LyricHa/ECEN403-CAPSTONE/ECEN404_Team60_Solar_Lighting_System/Presentations/ECEN 404 Presentations/PDFs/ECEN404_Presentation_2-28.pdf

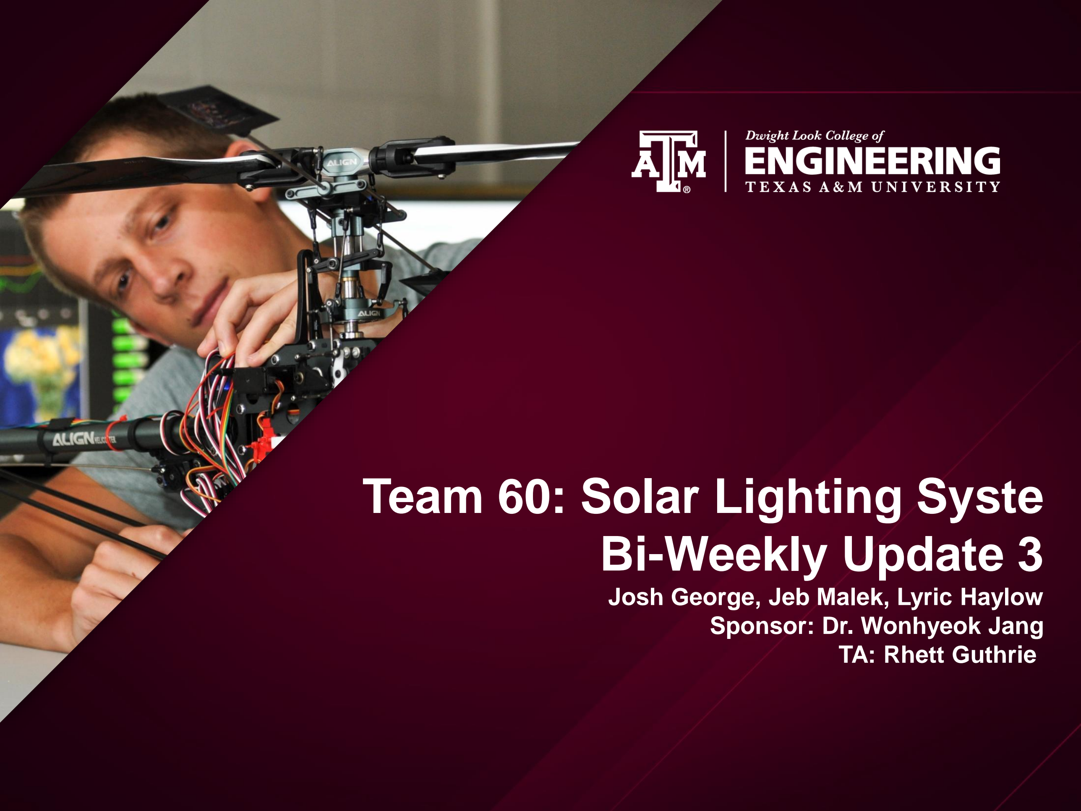
[picture p93: page 1]

# Team 60: Solar Lighting Syste Bi-Weekly Update 3

Josh George, Jeb Malek, Lyric Haylow Sponsor: Dr. Wonhyeok Jang TA: Rhett Guthrie

# Project Summary

### - A need for clean, renewable sources becomes more apparent

than ever.

### - Our home indoor and outdoor lighting system is the first step

towards this, using solar power.

### - Design an indoor/outdoor home lighting system that operates with

a battery, power conversion,

### mobile application functionality, BT microcontroller for switch automation from motion

sensors.

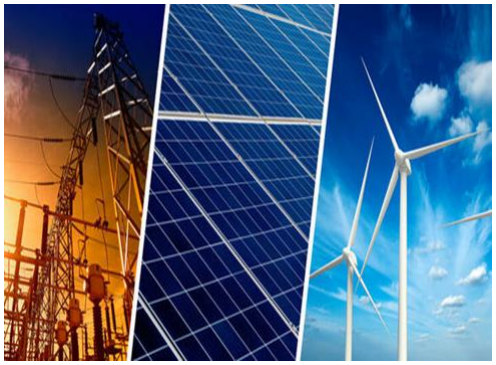
[picture p94: figure]

# Project/Subsystem Overview

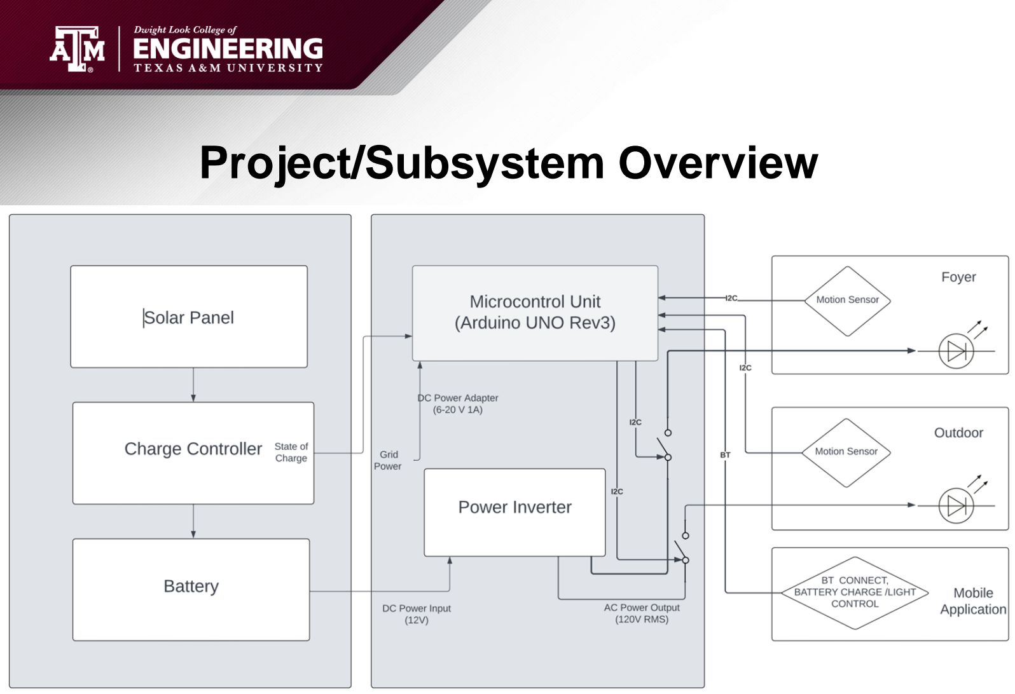
[picture p95: page 3]

# Project Timeline

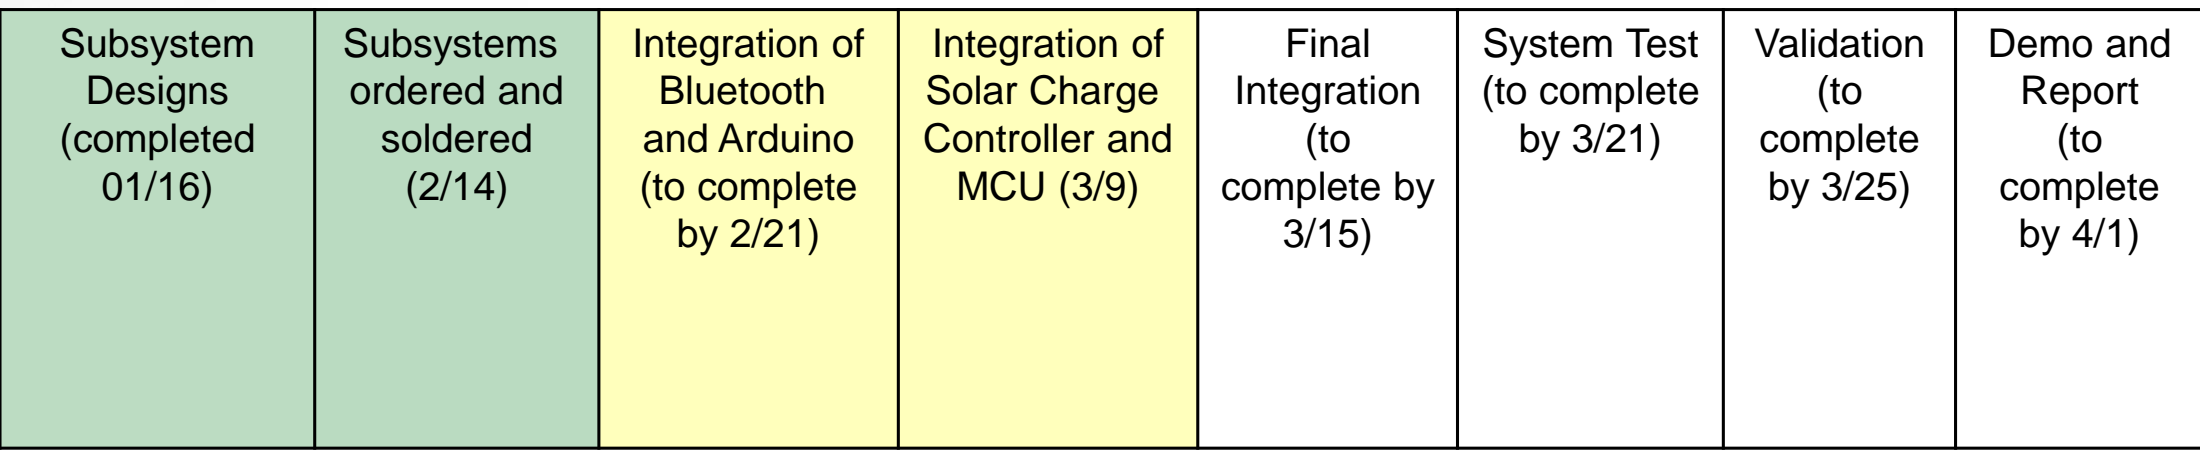
[picture p96: figure]
Subsystem Designs (completed 01/16); Subsystems ordered and soldered (2/14); Integration of Bluetooth and Arduino (to complete by 2/21); Integration; Solar; Charge; Controller; and; MCU; Final Integration (to complete by 3/15); System Test (to complete by 3/21); Validation (to complete by 3/25); Demo and Report (to complete by 4/1)

# Solar Charge Controller

Accomplishments since last update 10 hrs of effort | Ongoing progress/problems and plans until the next presentation
- PCB board soldered - Gotten voltage output from one of the solar panels, confirmed working - Preliminary datapoints for battery percentage attained. Likely wrong though. | - Print 3D model for enclosure over Blitz - Finish verifying necessary final values for Charge Controller - Sun is temperamental and necessary for good testing.

Time (AM) | Change in time (minutes) | Battery Voltage (Voltage

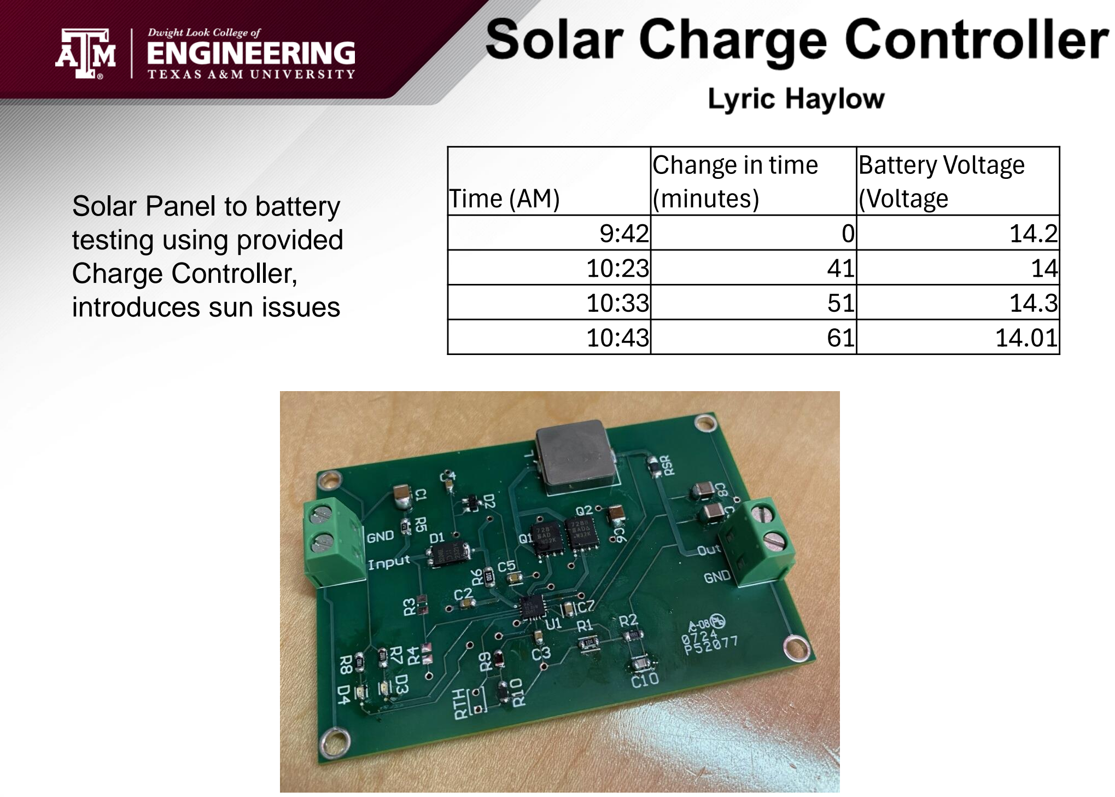
[picture p97: page 6]

9:42 | 0 | 14.2
10:23 | 41 | 14
10:33 | 51 | 14.3
10:43 | 61 | 14.01

Solar Panel to battery
testing using provided
Charge Controller,
introduces sun issues

# Inverter Subsystem

Jeb Malek

Accomplishments since 403 25 hrs of effort | Ongoing progress/problems and plans until the next presentation
Power transformer voltage invalidated In-circuit serial programming issue | PCB Correction Ordering Corrected Version Assembly & Validation 12V – 5V Converter PCB Order
- Evaluated Configuration Bits for Programming dsPIC

Speaking with sponsor about alternative changes to scope.

# Inverter Subsytem

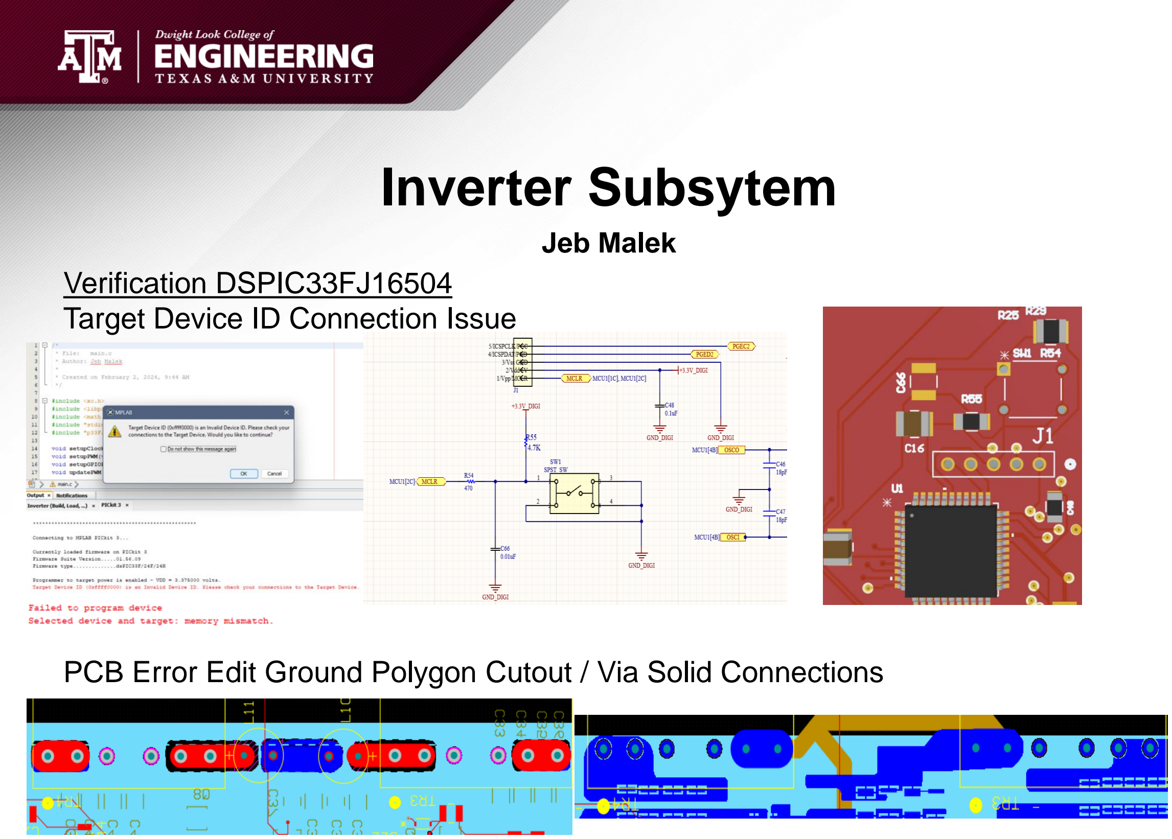
[picture p98: page 8]

Jeb Malek
Verification DSPIC33FJ16504 Target Device ID Connection Issue

PCB Error Edit Ground Polygon Cutout / Via Solid Connections

# Inverter Subsytem

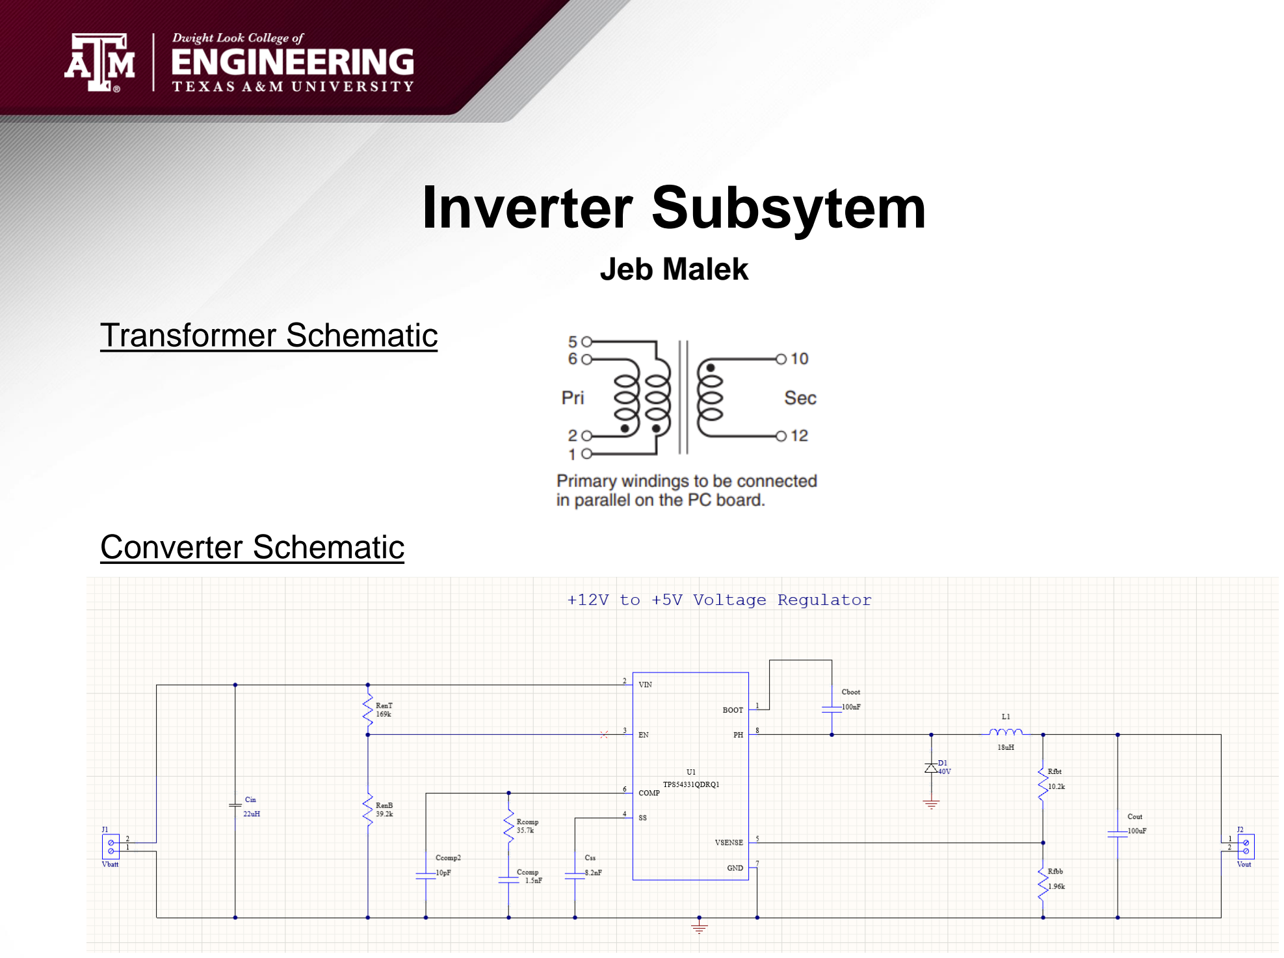
[picture p99: page 9]

Jeb Malek

Converter Schematic

Transformer Schematic

# Microcontroller Subsystem

Jeb Malek & Josh George

Accomplishments since 403 20 hrs of effort | Ongoing progress/problems and plans until the next presentation
Passive Infared (PIR) Sensors Tested Coded microcontroller sensor relay information | Testing of Sensor proximity & distance Testing of Controlled Relay Communication with Arduino Testing of Relay with Light Load
- Evaluated Sensor High & Low Communication Signal
- Future Test Bluetooth App with relay control, receive of motion sense, sign of demonstration structuring

# Microcontroller Subsytem

Jeb Malek & Josh George

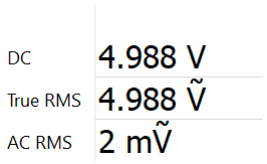
[picture p100: figure]

PIR Motion Sensor Test

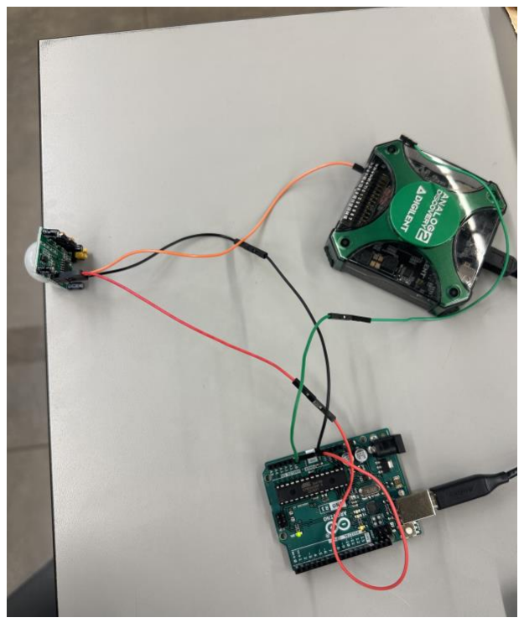
[picture p101: figure]
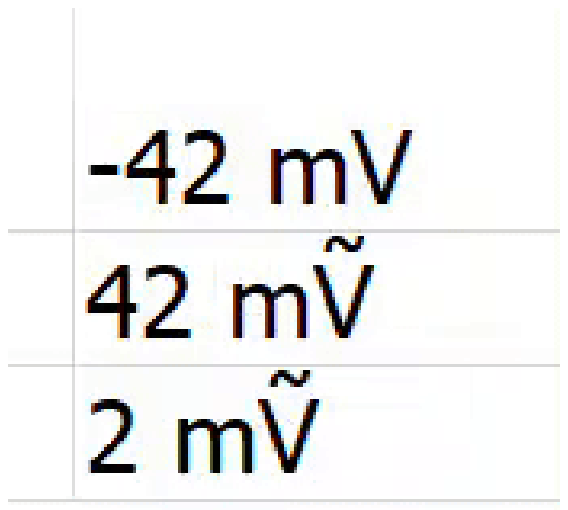
[picture p102: figure]

## Microcontroller Subsytem

Jeb Malek & Josh George Sensor 1 Reading Pin

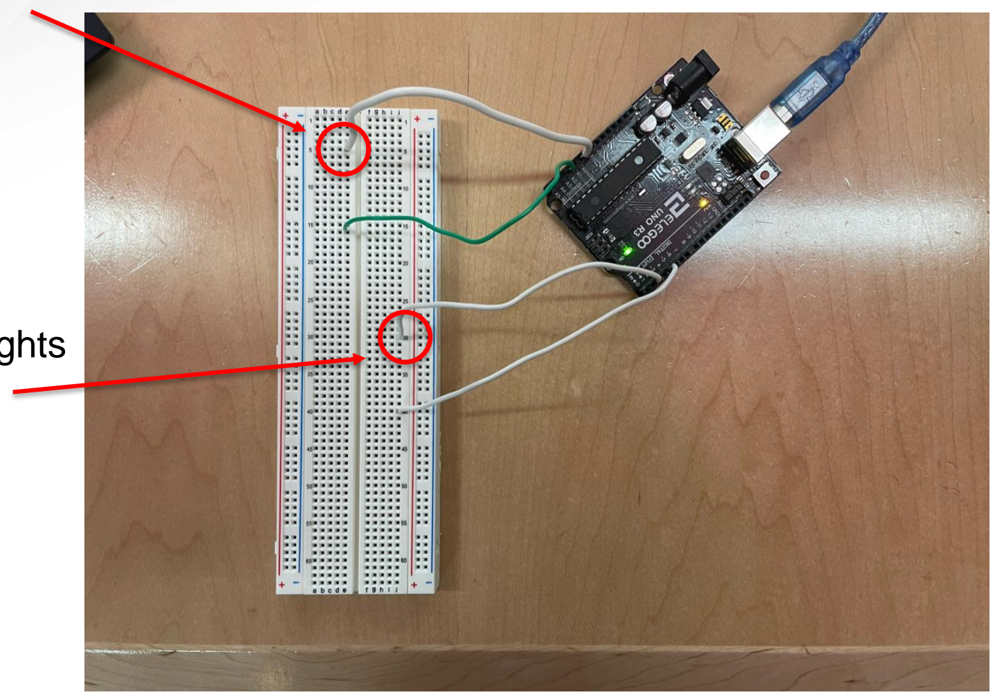
[picture p103: figure]

Sensor 1 Lights

## Microcontroller Subsytem

Jeb Malek & Josh George
Sensor 2 Reading Pin

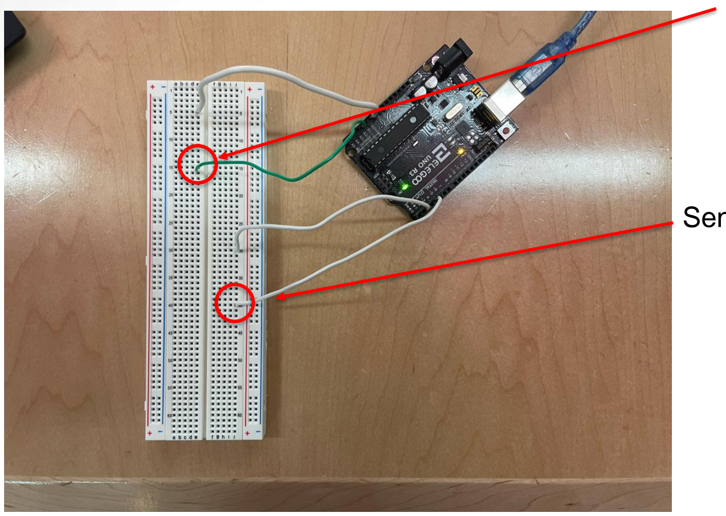
[picture p104: figure]

Sensor 2 Lights

## Microcontroller Subsytem

Jeb Malek & Josh George

# - Main error found during testing: Sensor 1 activates Sensor 2 lights too, and Sensor

2 activates sensor lights as well.

# Mobile Application

Josh George

Accomplishments since last update 2 hrs of effort | Ongoing progress/problems and plans until the next presentation
-Added Bluetooth special characters functionality. | -Finish coding microcontroller sensor relay. -Add input pin option for solar charge controller.

# Mobile Application

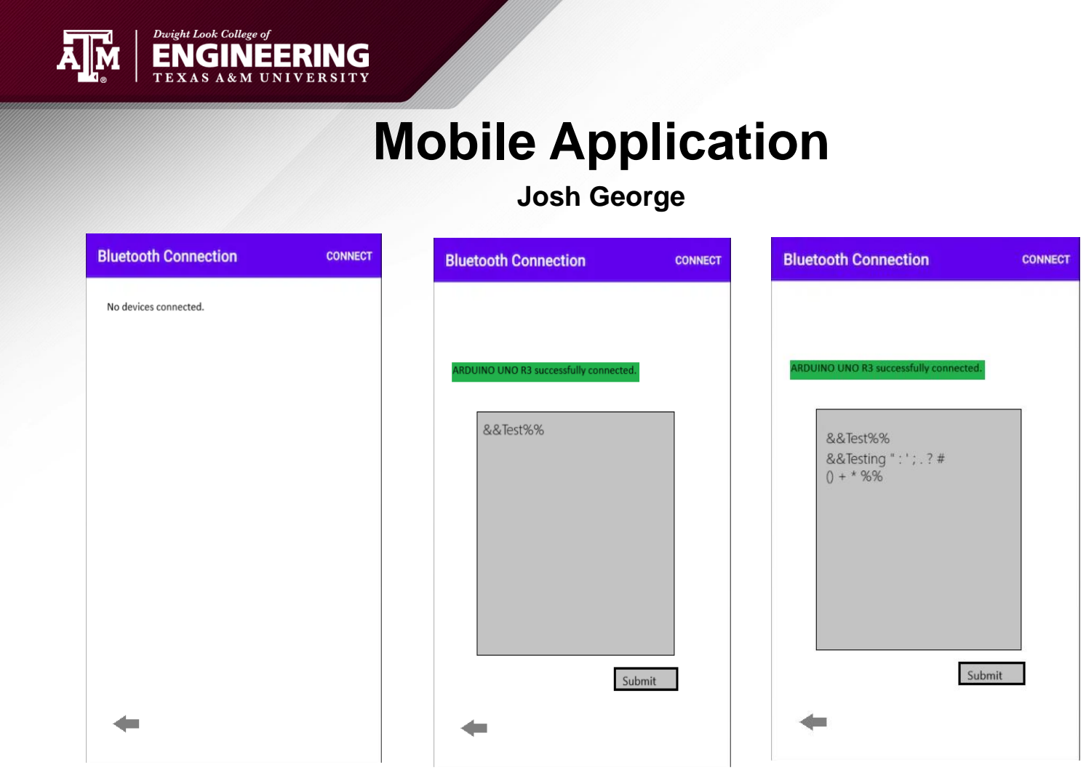
[picture p105: page 16]

Josh George

# Execution Plan

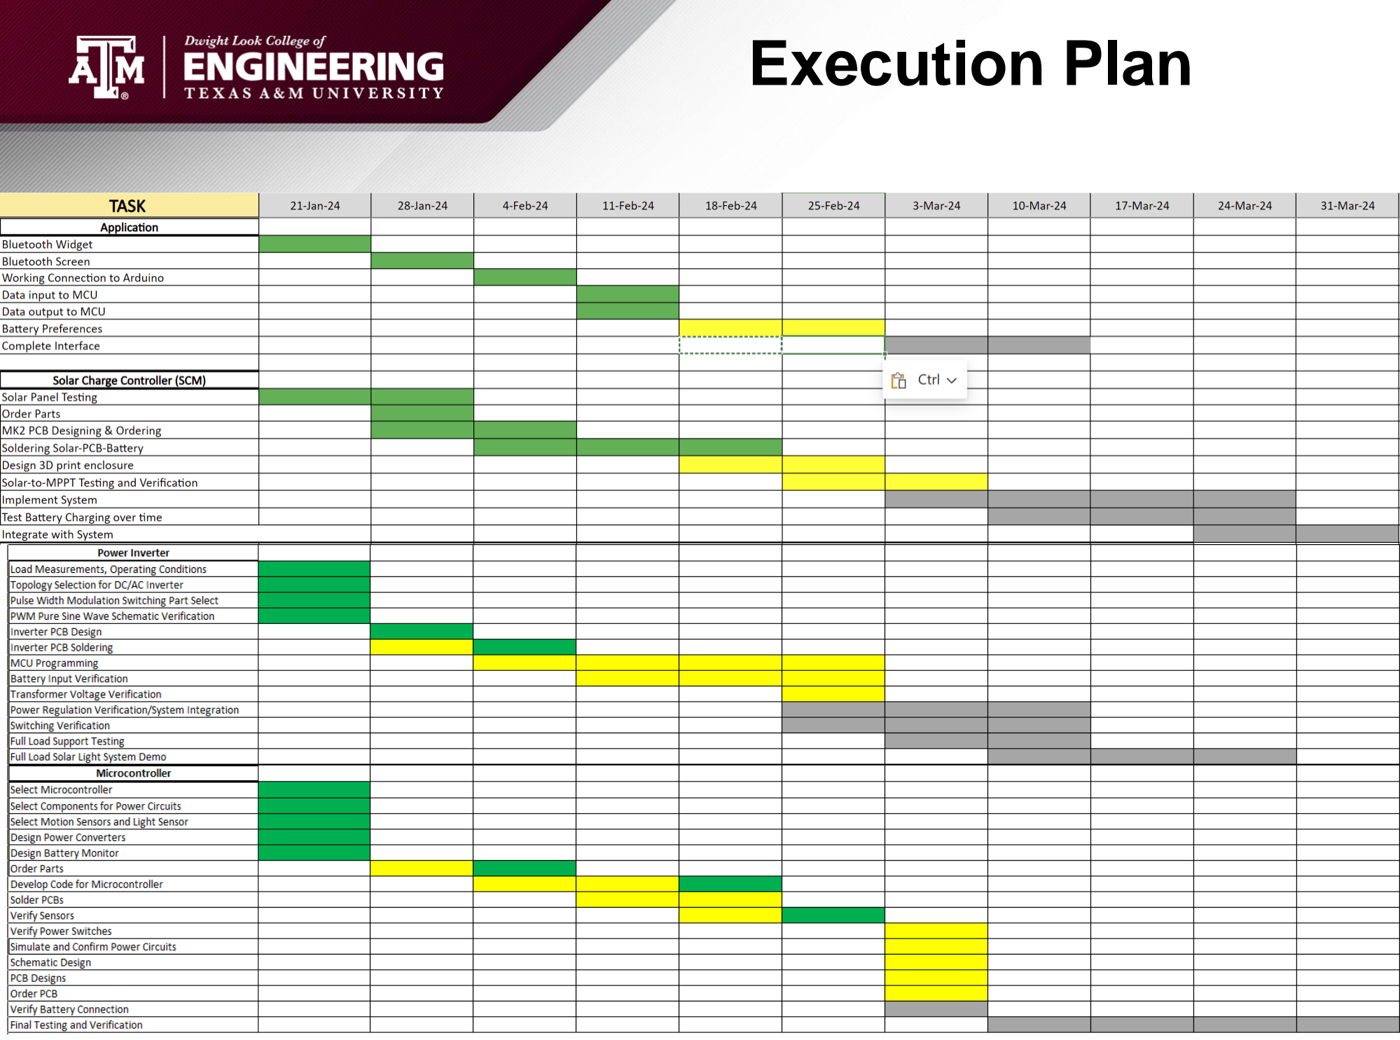
[picture p106: page 17]

# Validation Plan

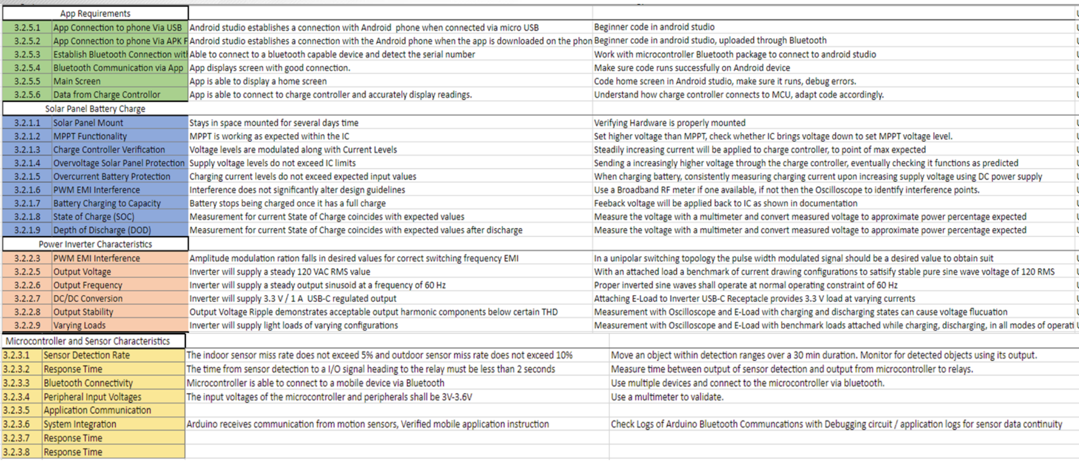
[picture p107: figure]
