LyricHa/ECEN403-CAPSTONE/ECEN404_Team60_Solar_Lighting_System/General/Budget_404_SolarLightingSystem.xlsx

Sheet: BUDGET
Designator | Part Number | Item Description | Quantity | Cost Per Part | Total Cost
SOLAR / CHARGE CONTROLLER
C1 | 399-C1210C225K1RAC7800CT-ND | General Purpose Ceramic Capacitor, 1210, 2.2uF, 10%, X7R, 15%, 100V | 1 | 0.69 | 0.69
C2, C3, C4 | 399-C0805C105K3RAC7800CT-ND | C0805C105K3RACTU | 3 | 0.13 | 0.69
C5, C7 | 399-C0805C104K5RAC7800CT-ND | CAP CER 0.1UF 50V X7R 0805 | 2 | 0.13 | 0.26
C6, C8 | 399-C1210C106M6PAC7800CT-ND | CAP CER 10UF 35V X5R 1210 | 2 | 0.79 | 1.58
C9 | 399-C1210C475M5RAC7800CT-ND | CAP 4.7uF 50V ±20% 1210 (3225 Metric) Thickness 2.8mm SMD | 1 | 1.5 | 1.5
C10 | 399-C0805C220K5GAC7800CT-ND | CAP CER 22PF 50V 10% NP0 0805 | 1 | 0.1 | 0.1
D1 | PDS1040LDICT-ND | DIODE SCHOTTKY 40V 10A POWERDI5 | 1 | 1 | 1
D2 | 4878-BAT54CCT-ND | DIODE ARRAY SCHOTTKY 30V SOT23-3 | 1 | 0.15 | 0.15
D3, D4 | 160-1183-1-ND | LED GREEN CLEAR CHIP SMD | 2 | 0.23 | 0.46
J1, J2 | 277-1247-ND | PCB Terminal Block, 13.5 A, 400 V, 2-Pin THD, RoHS, Bulk | 2 | 1.1 | 2.2
L | 541-1024-1-ND | Commercial Inductors, High Saturation Series 10uH 7A 34mΩ 20% | 1 | 1.52 | 1.52
Q1, Q2 | SI7288DP-T1-GE3CT-ND | Dual N-Channel (D-S) MOSFET, 40 V, 20 A, -55 to 150 degC, 8-Pin POWERPAKSO-8, RoHS, Tape and Reel | 2 | 1.47 | 2.94
R1 | P100KDACT-ND | RES 100K OHM 0.1% 1/8W 0805 | 1 | 0.31 | 0.31
R2, R3 | 541-3028-1-ND | RES SMD 499K OHM 1% 1/8W 0805 | 2 | 0.16 | 0.32
R4 | P36KBNCT-ND | RES SMD 36K OHM 0.5% 1/8W 0805 | 1 | 0.42 | 0.42
R5 | P2.2ACT-ND | RES SMD 2.2 OHM 5% 1/8W 0805 | 1 | 0.1 | 0.1
R6 | P10ECT-ND | RES SMD 10 OHM 5% 1/4W 1206 | 1 | 0.15 | 0.15
R7, R8 | 311-10.0KCRCT-ND | Chip Resistor, 10 KOhm, +/- 1%, 0.125 W, -55 to 155 degC, 0805 (2012 Metric), RoHS, Tape and Reel | 2 | 0.1 | 0.2
R9 | 541-5.23KCCT-ND | RES Thick Film, 5.23kΩ, 1%, 0.125W, 100ppm/°C, 0805 | 1 | 0.1 | 0.1
R10 | 541-30.1KCCT-ND | RES Thick Film, 30.1kΩ, 1%, 0.125W, 100ppm/°C, 0805 | 1 | 0.1 | 0.1
RSR | WSLP-.02CT-ND | RES 0.02 OHM 1% 1W 1206 | 1 | 0.6 | 0.6
RTH |  | Thermistor NTC 10KOhm 1% 2-Pin | 1
U | 296-27699-1-ND | IC SYNC SW-MODE BAT CHRGR 16VQFN | 1 | 5.94 | 5.94
 |  |  |  | Order Total Cost: | $21.33
LIGHTING
B081NHZHSD | https://www.amazon.com/Extension-Hanging-Lantern-Pendant-Lighting/dp/B081NHZHSD?hvadid=416713541504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 | 2-Pack Extension Hanging Lantern Cord Cable UL 375W with E26 E27 Socket On/Off Button Pendant Lighting - 6 Feet | 2 | 4.99 | 9.99
MSB1G | Southwire Southwire MSB1G One Gang Device Box with Depth Adjustable; Heavy Duty 42lb; Gray - Amazon.com (https://www.amazon.com/gp/product/B00H8NUVQK/ref=ox_sc_act_title_1?smid=ATVPDKIKX0DER&psc=1) | Southwire Southwire MSB1G One Gang Device Box with Depth Adjustable; Heavy Duty 42lb; Gray | 2 | 2.73 | 5.46
B0CJ9F8PBP | ELEGRP GFCI Outlet Outdoor, 20 Amp Self-Test GFI Electrical Outlet with Thinner Design, Weather & Tamper Resistant GFCI Receptacle, Ground Fault Receptacle w/Wall Plate, UL Listed, Matte White, 2 Pack - Amazon.com (https://www.amazon.com/ELEGRP-Self-Test-Electrical-Resistant-Receptacle/dp/B0CJ9F8PBP?s=industrial) | ELEGRP GFCI Outlet Outdoor, 20 Amp Self-Test GFI Electrical Outlet with Thinner Design, Weather & Tamper Resistant GFCI Receptacle, Ground Fault Receptacle w/Wall Plate, UL Listed, Matte White, 2 Pack | 2 | 12.5 | 24.99
HC-SR501 | Amazon.com: DIYmall 5 Pack HC-SR501 Pir Motion IR Sensor Body Module Infrared for Arduino : Electronics (https://www.amazon.com/gp/product/B012ZZ4LPM/ref=ewc_pr_img_4?smid=A28JUS3SJ1A0RV&psc=1) | DIYmall 5 Pack HC-SR501 Pir Motion IR Sensor Body Module Infrared for Arduino | 5 | 1.89 | 9.49
B079FJSYGY | Amazon.com: 4 pcs DC 5V 1 Channel Relay Module Board Shield High/Low Level Trigger with Optocoupler : Industrial & Scientific (https://www.amazon.com/gp/product/B079FJSYGY/ref=ewc_pr_img_5?smid=A11A70Q280RHPK&th=1) | 4 pcs DC 5V 1 Channel Relay Module Board Shield High/Low Level Trigger with Optocoupler | 4 | 1.35 | 5.4
146248 | Primary Wire Connector Kit 600 Piece | Remy Battery (https://remybattery.com/160901-primary-wire-connector-kit-160901.html) | 600 Piece PVC Primary Wire Connector Kit | 2 | -
S1 | https://www.amazon.com/dp/B08PFB4HDT?smid=A2N7NRZ9X3BHHN&ref_=chk_typ_imgToDp&th=1 | Wihte Cord Mesh Organizer | 1 | 9.99 | 9.99
S2 | Steel Tubing for Structure |  | 1 | -
 |  |  |  | Order Total Cost: | $65.32
Power Converter
Cboot | CAP CER 0.1UF 50V X7R 1210 | https://www.digikey.com/en/products/detail/yageo/CC1210KKX7R9BB104/5884736 |  | 3 | $1.29
Ccomp | CAP CER 1000PF 100V X7R 1210 | https://www.digikey.com/en/products/detail/kyocera-avx/KGM32RR72A102KU/563710 |  | 3 | $1.86
Ccomp2 | CAP CER 10PF 50V C0G/NPO 0805 | https://www.digikey.com/en/products/detail/yageo/CC0805JRNPO9BN100/302833 |  | 3 | $0.30
Cin | CAP CER 22UF 25V X5R 1210 | https://www.digikey.com/en/products/detail/samsung-electro-mechanics/CL32A226KAJNNNE/3886759 |  | 3 | $1.32
Cout | CAP CER 47UF 16V X6S 1210 | https://www.digikey.com/en/products/detail/murata-electronics/GRM32EC81C476KE15K/7363053 |  | 3 | $1.56
Css | CAP CER 8200PF 50V C0G/NP0 1210 | https://www.digikey.com/en/products/detail/vishay-vitramon/VJ1210A822JXAAT/8320960 |  | 3 | $3.09
D1 | DIODE SCHOTTKY 40V 0.5A SMA | https://www.digikey.com/en/products/detail/rohm-semiconductor/RB400VYM-50FHTR/8028520 |  | 3 | $1.26
Rcomp | RES SMD 56.2K OHM 1% 1/2W 1210 | https://www.digikey.com/en/mylists/list/SW46HQUBVC |  | 3 | $1.11
Rfbt | RES SMD 10.2K OHM 1% 1/2W 1210 | https://www.digikey.com/en/products/detail/panasonic-electronic-components/ERJ-14NF1022U/383823 |  | 3 | $1.11
Rfbb | RES SMD 1.96K OHM 1% 1/2W 1210 | https://www.digikey.com/en/products/detail/panasonic-electronic-components/ERJ-14NF1961U/383938 |  | 3 | $1.11
RenB | RES SMD 39.2K OHM 1% 1/2W 1210 | https://www.digikey.com/en/products/detail/panasonic-electronic-components/ERJ-14NF3922U/384079 |  | 3 | $1.11
RenT | RES SMD 169K OHM 1% 1/2W 1210 | https://www.digikey.com/en/products/detail/panasonic-electronic-components/ERJ-14NF1693U/383911 |  | 3 | $1.11
J1, J2 | TERM BLK 2POS SIDE ENTRY 5MM PCB | https://www.digikey.com/en/products/detail/w%C3%BCrth-elektronik/691137710002/6644051 |  | 6 | $2.46
L1 | IND 22UH 3A 80 MOHM SMD | https://www.digikey.com/en/products/detail/bourns-inc/SDR1105-220ML/2561904 |  | 3 | $2.94
U1 | TPS54233DR Buck Switching Regulator IC Positive Adjustable 0.8V 1 Output 2A 8-SOIC | https://www.digikey.com/en/products/detail/texas-instruments/TPS54233DR/1967861 |  | 3 | $5.10
 |  |  |  | Total Cost | $26.73
 |  |  |  |  | $34.14
 |  |  |  | Spent To Date: | $120.79
 |  |  |  | Budget Remainer | $279.21

Sheet: INVERTER
INVERTER
C1 | HMK316B7105KL-T | 1 µF ±10% 100V Ceramic Capacitor X7R 1206 (3216 Metric) | 1 | $0.231 | $0.231
C2 | C1210C104K1RACAUTO | 0.1 µF ±10% 100V Ceramic Capacitor X7R 1210 (3225 Metric) | 1 | $0.234 | $0.234
C3,C10,C11,C12,C13,C14,C16, | CC1210KKX7R9BB103 | 0.01 uF 10000 pF ±10% 50V Ceramic Capacitor X7R 1210 (3225 Metric) | 7 | $0.450 | $3.150
C4,C7,C8, C44,51,64 | CC1206KRX7R9BB104 | 0.1 µF ±10% 50V Ceramic Capacitor X7R 1206 (3216 Metric) | 6 | $0.135 | $0.810
C5, C20, C25, C29, C39,C60 | CC1210KKX7R7BB105 | 1 µF ±10% 16V Ceramic Capacitor X7R 1210 (3225 Metric) | 6 | $0.298 | $1.788
C6 | TAJD107K016RNJ | 100 µF ±20% 16\V Ceramic Capacitor X5R 1210 (3225 Metric) | 1 | $0.630 | $0.630
C25, C26, C27,C28, C29 | UPW1J222MHD | 2200 µF 63 V Aluminum Electrolytic Capacitors Radial, Can 8000 Hrs @ 105°C | 5 | $0.129 | $0.645
C31 | CC1206KRX7R9BB822 | 10 µF ±10% 100V Ceramic Capacitor X7S 1210 (3225 Metric) | 1 | $0.240 | $0.240
C43, C44 | BFC233920104 | 0.1 µF Film Capacitor 310V 630V Polypropylene (PP), Metallized Radial | 2 | $0.230 | $0.460
C45 | GA343DR7GD472KW01L | 4700 pF ±10% 250VAC Ceramic Capacitor X7R 1812 (4532 Metric) | 1 | $0.210 | $0.210
C46,C47,C50, C54,C55,C61,C62 | CL31A106KOHNNNE | 10 µF ±10% 16V Ceramic Capacitor X5R 1206 (3216 Metric) | 7 | $0.110 | $0.770
C65 | BFC238330153 | 0.015 µF Film Capacitor 350V 1000V (1kV) Polypropylene (PP), Metallized Radial | 1 | $1.430 | $1.430
D1 | DSS16U | Diode 60 V 1A Surface Mount SOD-123FL | 1 | $1.760 | $1.760
D2 | NSR05T40P2T5G | DIODE SCHOTTKY 40V 500MA SOD923 | 1 | $0.950 | $0.950
D3 | B0520WS-7-F | Diode 20 V 500mA Surface Mount SOD-323 | 1 | $1.760 | $1.760
D10 | 1N4148WX-TP | Diode 75 V 150mA Surface Mount SOD-323 | 1 | $0.790 | $0.790
J1 | PPTC051LFBN-RC | Vertical 0.100" (2.54mm) Through Hole Tin | 1 | $0.890 | $0.890
J4 | 387206303 | 3 Circuit 0.375" (9.53mm) Barrier Block Connector Screws | 1 | $3.149 | $3.149
L1 | SRR7045-221M | 220 µH Shielded Drum Core, Wirewound Inductor 640 mA 700mOhm Max Nonstandard | 1 | $2.360 | $2.360
L2 | HC1-R22-R | 220 nH Unshielded Drum Core, Wirewound Inductor 51.42 A 0.36mOhm Max Nonstandard | 1 | $0.240 | $0.240
L3,L4 | BLM41PG600SN1L | 60 Ohms @ 100 MHz 1 Power Line Ferrite Bead 1806 (4516 Metric) 6A 9mOhm | 2 | $0.154 | $0.308
L5,L6 | BRL3225T100K | 10 µH Unshielded Drum Core, Wirewound Inductor 700 mA 420mOhm Max 1210 (3225 Metric) | 2 | $0.220 | $0.440
MH1, MH2, MH3, MH4 | PMSSS 440 0025 PH | #4-40 Pan Head Machine Screw Phillips Drive Stainless Steel | 4 | $0.100 | $0.400
MOV1, MOV2 | B72214P2271K101 | VARISTOR 430V 6KA DISC 14MM | 2 | $0.630 | $1.260
Q2, Q3, Q4, Q5 | IPB60R190C6ATMA1‎ | N-Channel 600 V 20.2A (Tc) 151W (Tc) Surface Mount PG-TO263-3 | 4 | $3.250 | $13.000
Q6, Q8 | SI7115DN-T1-GE3 | MOSFET P-CH 150V 8.9A D2PAK1212-8 | 2 | $2.000 | $4.000
R1,R16,R20,R24,R28,R51 | ERJ-14YJ332UU | 10 kOhms ±1% 0.25W, 1/4W Chip Resistor 1206 (3216 Metric) Automotive AEC-Q200 Thick Film RES SMD 10KOHM 0.01% 0.6W J LEAD | 6 | $0.122 | $0.732
R2 | RK73B2ETTD332J | 3.3 kOhms ±5% 0.5W, 1/2W Chip Resistor 1210 (3225 Metric) Automotive AEC-Q200 Thick Film | 1 | $0.120 | $0.120
R3 | ERJ-14NF1653U | 165 kOhms ±1% 0.5W, 1/2W Chip Resistor 1210 (3225 Metric) Automotive AEC-Q200 Thick Film | 1 | $0.360 | $0.360
R4 | ERA-8ARW1022V | 10.2 kOhms ±0.05% 0.25W, 1/4W Chip Resistor 1206 (3216 Metric) Automotive AEC-Q200 Thin Film | 1 | $1.470 | $1.470
R5 | ERJ-14BQF1R5U | 1.5 Ohms ±1% 0.5W, 1/2W Chip Resistor 1210 (3225 Metric) Automotive AEC-Q200, Current Sense Thick Film | 1 | $0.343 | $0.343
R6 | ERJ-14NF1693U | 169 kOhms ±1% 0.5W, 1/2W Chip Resistor 1210 (3225 Metric) Automotive AEC-Q200 Thick Film | 1 | $0.393 | $0.393
R7 | CRCW12062K70FKEAHP | 2.7 kOhms ±1% 0.75W, 3/4W Chip Resistor 1206 (3216 Metric) Automotive AEC-Q200, Pulse Withstanding Thick Film | 1 |  | $0.000
R8, R9, R30,R31 | RC1206FR-071KL | 1 kOhms ±1% 0.25W, 1/4W Chip Resistor 1206 (3216 Metric) Moisture Resistant Thick Film | 4 |  | $0.000
R10,11 | RM2012A-103/103-PBVW10 | 10k Ohm ±0.1% 50mW Power Per Element Voltage Divider 2 Resistor Network/Array ±25ppm/°C 0805 (2012 Metric), Long Side Terminals | 2 | $1.480 | $2.960
R12,R13, R14, R18, R22, R26 | RC1206FR-0711RL | 11 Ohms ±1% 0.25W, 1/4W Chip Resistor 1206 (3216 Metric) Moisture Resistant Thick Film | 6 | $0.036 | $0.216
R15,R19,R23,R27 | ERJ-P14J1R0U | 1 Ohms ±5% 0.5W, 1/2W Chip Resistor 1210 (3225 Metric) Automotive AEC-Q200, Pulse Withstanding Thick Film | 4 | $0.220 | $0.880
R16, R20, R24, R28, R32, R33, R40, R41, R47, R48, R49, R50, R51 | RMCF1206FT10K0 | 10 kOhms ±0.05% 0.25W, 1/4W Chip Resistor 1206 | 13 | $0.100
R17, R21, R25, R29 | CRGP1210F270R | 270 Ohms ±1% 0.75W, 3/4W Chip Resistor 1210 (3225 Metric) Pulse Withstanding Thick Film | 4 | $0.146 | $0.584
R34,R37 | ERJ-S140R00U | 0 Ohms Jumper Chip Resistor 1210 (3225 Metric) Anti-Sulfur, Automotive AEC-Q200 Thick Film | 2 | $0.210 | $0.420
R52 | ERJ-14NF5232U | 52.3 kOhms ±1% 0.5W, 1/2W Chip Resistor 1210 (3225 Metric) Automotive AEC-Q200 Thick Film | 2 | $0.360 | $0.720
TR1 TR2 | DA2320-ALB | Gate Drive Transformer | 2 | $2.020 | $4.040
TR3, TR4 | NA5919-AL | Inductance is for the primary, measured at 150 kHz, 0.1 Vrms, 0 Adc,0A Inductance : 55uH(Tolerance: ±10%) Inductance min at 13.6A Pri 0.048 Sec 0.110 Leakage Inductance max 1.58 uH Pri Turns 1:4 Isolation Voltage | 2 | $9.790 | $19.580
U1 | DSPIC33FJ16GS504-I/PT | dsPIC33F Microcontroller IC 16-Bit 40 MIPs 16KB (16K x 8) FLASH | 1 | $6.360 | $6.360
U2 | LM5008AMM/NOPB | Buck Switching Regulator IC Positive Adjustable 2.5V 1 Output 350mA 8-TSSOP, 8-MSOP (0.118", 3.00mm Width) | 1 | $3.730 | $3.730
U3 | MCP14E4T-E/SN | 4 A Dual High Speed Power MOSFET Driver IC | 1 | $2.450 | $2.450
U4, U5 | FOD817ASD | Optoisolatior Transistor 5kV 4SMD | 2 | $0.390 | $0.780
U6 | MCP16301T-I/CHY | Buck Switching Regulator IC Positive Adjustable 2V 1 Output 600mA SOT-23-6 | 1 | $1.360 | $1.360
U7 | MCP1700T-3302E/MB | Linear Voltage Regulator IC Positive Fixed 1 Output 250mA SOT-89-3 | 1 | $0.500 | $0.500
PCB Board | PCB1 | Printed Circuit Board, Manufactured by Advanced Circuits, Denver, CO | 1 | $66.000 | $66.000
 |  |  |  | Order Total Cost: | $155.90
