LyricHa/ECEN403-CAPSTONE/ECEN404_Team60_Solar_Lighting_System/General/Execution_Validation.xlsx

Sheet: Execution_Plan
TASK | 2023-09-24 | 2023-10-05 | 2023-10-12 | 2023-10-19 | 2023-10-26 | 2023-11-02 | 2023-11-09 | 2023-11-16 | 2023-11-23
Application
Kotlin Modules
Main Screen
All Main Screen Buttons
About Screen
User Settings
Battery Preferences
Battery Level
Weather Data Input
Microcontroller Connection
Solar Charge Controller (SCM)
Solar Panel Selection
Select MPPT
Solar Power Calculations
Solar Panel Testing
Schematic Design
PCB Designing
Order Parts
Soldering Solar-PCB-Battery
Solar-to-MPPT Testing and Verification
Power Inverter
Load Measurements, Operating Conditions
Topology Selection for DC/AC Inverter
Pulse Width Modulation Switching Part Select
PWM Pure Sine Wave Schematic Verification
Inverter PCB Design
Inverter PCB Soldering
Battery Input Verification
Power Regulation Verification
Transformer/Voltage Conversion Verification
Switching Verification
Full Load Support Testing
Inverter System Demo
Microcontroller
Select Microcontroller
Select Components for Power Circuits
Select Motion Sensors and Light Sensor
Design Power Converters
Design Battery Monitor
Order Parts
Simulate and Confirm Power Circuits
Schematic Design
PCB Designs
Order PCB
Develop Code for Microcontroller
Solder PCBs
Verify Sensors
Verify Power Circuits
Verify Battery Monitor
Final Testing and Verification

Sheet: Execution_Plan (2)
TASK | 2024-01-21 | 2024-01-28 | 2024-02-04 | 2024-02-11 | 2024-02-18 | 2024-02-25 | 2024-03-03 | 2024-03-10 | 2024-03-17
Application
Bluetooth Widget
Bluetooth Screen
Working Connection to Arduino
Data input to MCU
Data output to MCU
Graphing Interface
Battery Preferences
Arduino Voltage Input
Arduino Voltage Output
Complete Interface
Solar Charge Controller (SCM)
Solar Panel Testing
Order Parts
MK2 PCB Designing & Ordering
Soldering Solar-PCB-Battery
Test Battery Charging over time
Design 3D print enclosure
Solar-to-MPPT Testing and Verification
Implement System
Power System
Load Measurements, Operating Conditions
Topology Selection for DC/AC Inverter
Pulse Width Modulation Switching Part Select
PWM Pure Sine Wave Schematic Verification
Inverter PCB Design
Inverter PCB Soldering
MCU Programming
Transformer Voltage Verification
Power Regulation Verification/System Integration
Switching Verification
Full Load Support Testing
Full Load Solar Light System Demo
Microcontroller
Select Microcontroller
Select Components for Power Circuits
Select Motion Sensors and Light Sensor
Design Battery Monitor
Order Parts
Develop Code for Microcontroller
Verify Sensors
Verify Power Switches
Verify Motion Sensor/Switch Synchronization
Verify Battery Connection/Converter
Final Testing and Verification | `

Sheet: Validation
Paragraph # | Test Name | Success Criteria | Methodology | Status | Responsible Engineer
App Requirements |  |  |  | SUCCESS | Josh George
3.2.5.1 | App Connection to phone Via USB | Android studio establishes a connection with Android phone when connected via micro USB | Beginner code in android studio | SUCCESS | Josh George
3.2.5.2 | App Connection to phone Via APK File | Android studio establishes a connection with the Android phone when the app is downloaded on the phone via the APK file | Beginner code in android studio, uploaded through Bluetooth | SUCCESS | Josh George
3.2.5.3 | Establish Bluetooth Connection with App | Able to connect to a bluetooth capable device and detect the serial number | Work with microcontroller Bluetooth package to connect to android studio | SUCCESS | Josh George
3.2.5.4 | Bluetooth Communication via App | App displays screen with good connection. | Make sure code runs successfully on Android device | SUCCESS | Josh George
3.2.5.5 | Main Screen | App is able to display a home screen | Code home screen in Android studio, make sure it runs, debug errors. | SUCCESS | Josh George
3.2.5.6 | Data from Charge Controllor | App is able to connect to charge controller and accurately display readings. | Understand how charge controller connects to MCU, adapt code accordingly. | SUCCESS | Josh George
Solar Panel Battery Charge
3.2.1.1 | Solar Panel Mount | Stays in space mounted for several days time | Verifying Hardware is properly mounted | SUCCESS | Lyric Haylow
3.2.1.2 | MPPT Functionality | MPPT is working as expected within the IC | Set higher voltage than MPPT, check whether IC brings voltage down to set MPPT voltage level. | SUCCESS | Lyric Haylow
3.2.1.3 | Charge Controller Verification | Voltage levels are modulated along with Current Levels | Steadily increasing current will be applied to charge controller, to point of max expected | SUCCESS | Lyric Haylow
3.2.1.4 | Overvoltage Solar Panel Protection | Supply voltage levels do not exceed IC limits | Sending a increasingly higher voltage through the charge controller, eventually checking it functions as predicted | SUCCESS | Lyric Haylow
3.2.1.5 | Overcurrent Battery Protection | Charging current levels do not exceed expected input values | When charging battery, consistently measuring charging current upon increasing supply voltage using DC power supply | SUCCESS | Lyric Haylow
3.2.1.6 | PWM EMI Interference | Interference does not significantly alter design guidelines | Use a Broadband RF meter if one available, if not then the to identify interference points. | SUCCESS | Lyric Haylow
3.2.1.7 | Battery Charging to Capacity | Battery stops being charged once it has a full charge | Feeback voltage will be applied back to IC as shown in documentation | SUCCESS | Lyric Haylow
3.2.1.8 | State of Charge (SOC) | Measurement for current State of Charge coincides with expected values | Measure the voltage with a multimeter and convert measured voltage to approximate power percentage expected | SUCCESS | Lyric Haylow
3.2.1.9 | Depth of Discharge (DOD) | Measurement for current State of Charge coincides with expected values after discharge | Measure the voltage with a multimeter and convert measured voltage to approximate power percentage expected | SUCCESS | Lyric Haylow
3.2.1.10 | Functional Charge Controller | Charge controller works as specified in project report. | Test and Validate entire subsystem. | FAILED
Power Inverter Characteristics
3.2.2.1 | Output Voltage | Inverter will supply a steady 120 VAC RMS value | With an attached load a benchmark of current drawing configurations to satisify stable pure sine wave voltage of 120 VAC | SUCCESS | Jeb Malek
3.2.2.2 | Output Frequency | Inverter will supply a steady output sinusoid at a frequency of 60 Hz | Proper inverted sine waves shall operate at normal operating constraint of 60 Hz | SUCCESS | Jeb Malek
3.2.2.3 | DC/DC Conversion | Inverter will supply 5V / 1 A regulated output | Attaching E-Load to Inverter USB-C Receptacle provides 5 V load at varying currents | SUCCESS | Jeb Malek
3.2.2.4 | Output Stability | Output Voltage is maintained at desired value | Measurement with load with charging and discharging states and verifying voltage flucuation | SUCCESS | Jeb Malek
3.2.2.5 | Varying Loads | Inverter will supply light loads of varying configurations | Measurement with E-Load with benchmark loads attached while charging, discharging, in all modes of operation | SUCCESS | Jeb Malek
3.2.2.6 | Switching Continuity | Inverter will supply loacd when varying switching configurations are accuated | Measurement with E-Load with benchmark loads attached while Solid State Relays perform circuit configurations | SUCCESS | Jeb Malek
3.2.2.7 | Integrated Subsystems | Inverter will supply full load when sensors circuit is controlling solid state relays | Measurement with Multi-Meter to check voltage currents and line frequency under changing load conditions | SUCCESS | Jeb Malek
3.2.2.8 | Integrated Subsystems | Inverter will maintain load voltage and current when supporting microcontroller and charge controlling circuits are attached. | Measurement with and Multi-Meter to check voltage currents and line frequency under changing load conditions | SUCCESS | Jeb Malek
Microcontroller and Sensor Characteristics
3.2.3.1 | Switch Voltage | The indoor sensor miss rate does not exceed 5% and outdoor sensor miss rate does not exceed 10% | Move an object within detection ranges over a 30 min duration. Monitor for detected objects using its output | SUCCESS | Jeb Malek
3.2.3.2 | Switch Control | The control of AC relay with digital signal | Communication of digial output of switch pin and output from microcontroller to relays to control an AC Load | SUCCESS | Jeb Malek
3.2.3.3 | Bluetooth Connectivity | Microcontroller is able to connect to a mobile device via Bluetooth | Use multiple devices and connect to the microcontroller via bluetooth module | SUCCESS | Jeb Malek & Josh George
3.2.3.5 | Application Communication | Arduino receives communication from Bluetooth Module, and can communicate mobile application | Verifying digital pin setting for manual mode operate at appliaction button pushes actuate relays and set mode of operation to motion. | SUCCESS | Jeb Malek & Josh George
3.2.3.4 | Motion Sensor Voltages | The input voltages of the microcontroller and peripherals shall be 5V nominal | Using a multimeter to validate the correct voltage levels and taking current readings | SUCCESS | Jeb Malek
3.2.3.7 | Response Time | Arduino receives communication from motion sensors that can operate at a timing range that operates with switches | Verifying sensitivity setting for motion sensor can operate at its optimal distance triggering limits | SUCCESS | Jeb Malek
3.2.3.8 | Sensitivity | Arduino receives communication from motion sensors that can operate at maximum distant range | Verifying sensitivity setting for motion sensor can operate at its optimal distance triggering limits | SUCCESS | Jeb Malek
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
